elsaadamer/AI-crane-automation/docs/comparison_cam2.jpg

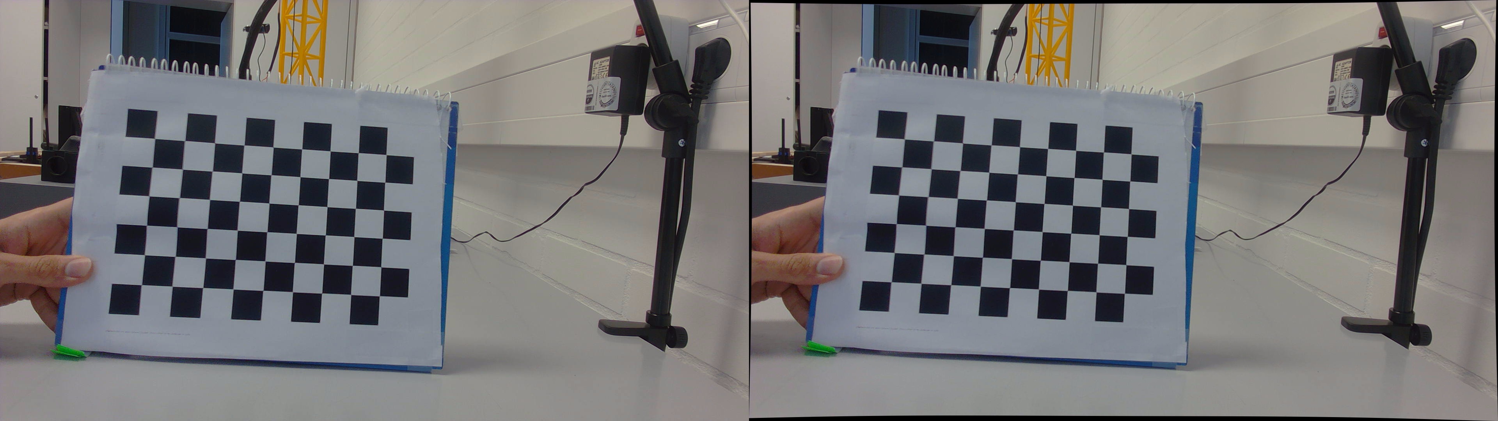
docs/comparison_cam2.jpg
