elsaadamer/AI-crane-automation/docs/homography_cam1_reference.jpg

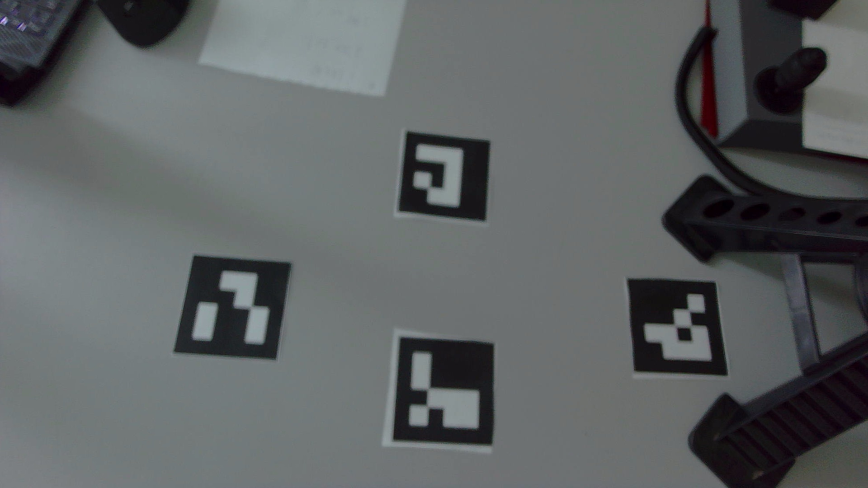
docs/homography_cam1_reference.jpg
