elsaadamer/AI-crane-automation/docs/undistorted_cam1.jpg

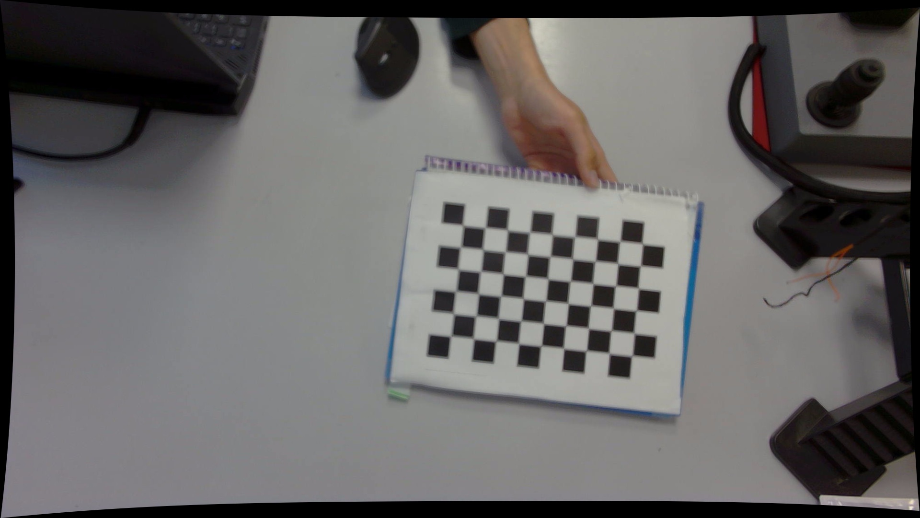
docs/undistorted_cam1.jpg
