elsaadamer/AI-crane-automation/docs/undistorted_cam2.jpg

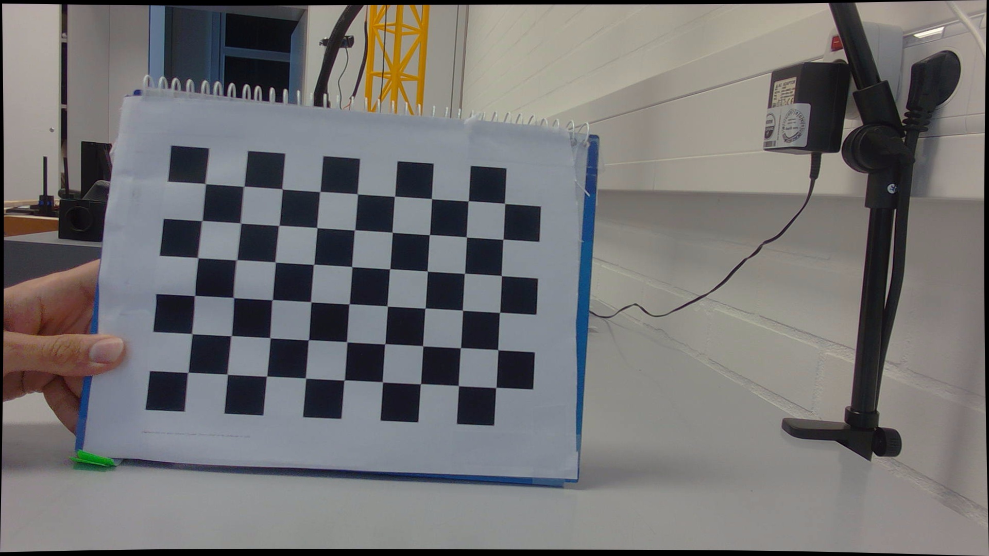
docs/undistorted_cam2.jpg
